rutubetsiz/uyanik/docs/case.png

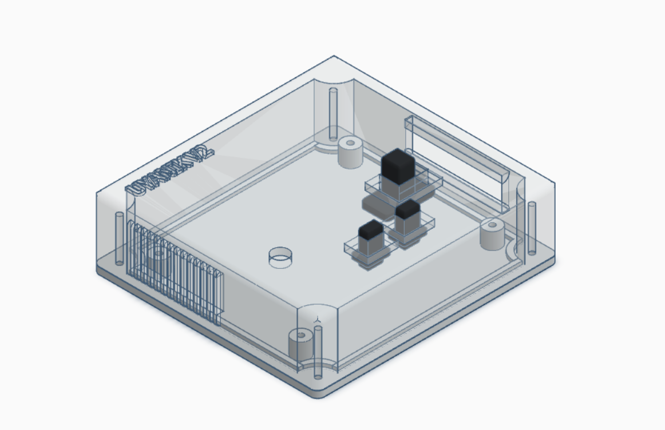
docs/case.png
