rutubetsiz/uyanik/docs/pcb.png

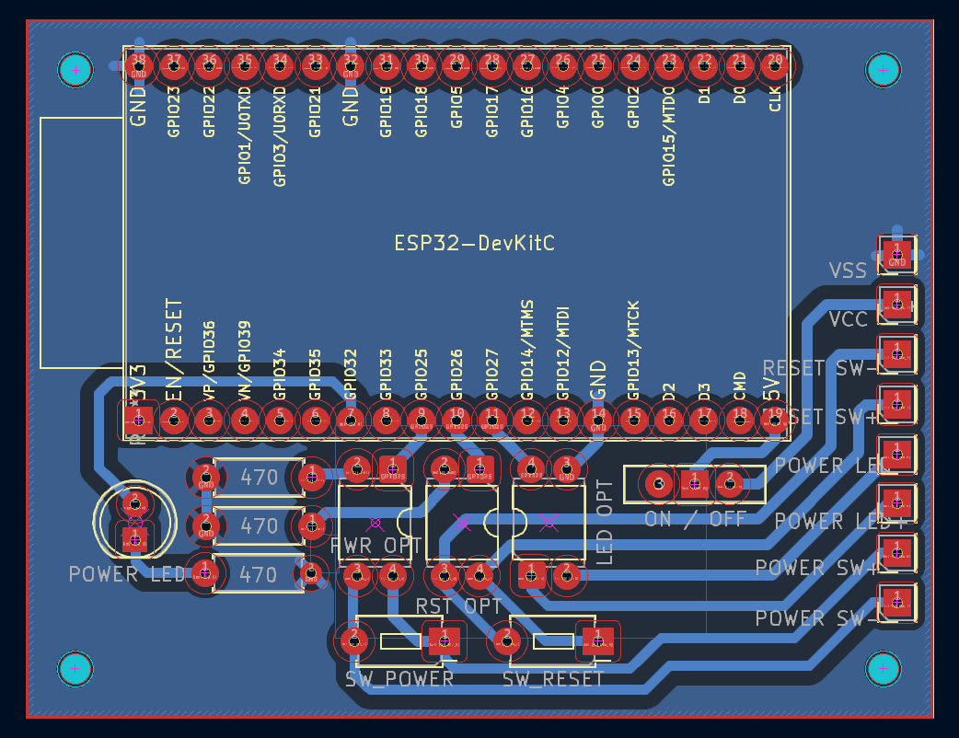
docs/pcb.png
