rutubetsiz/uyanik/case/UYANIK V2.stl

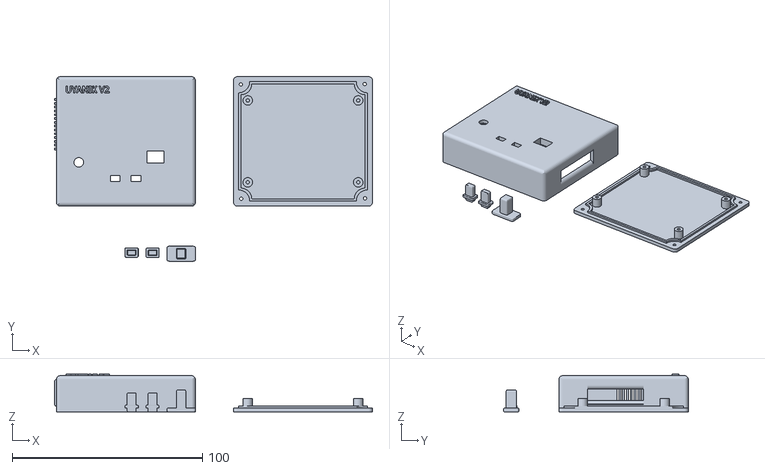
[picture p4: CAD file, 2026-10-16]
case/UYANIK V2.stl
167.0 x 97.0 x 19.8
