rutubetsiz/uyanik/hardware/UYANIK PCB.stl

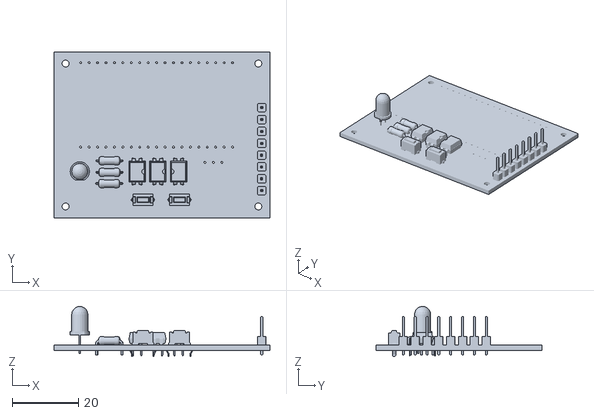
[picture p5: CAD file, 2026-10-16]
hardware/UYANIK PCB.stl
65.0 x 50.0 x 15.1
