rutubetsiz/uyanik/docs/Schematic.pdf

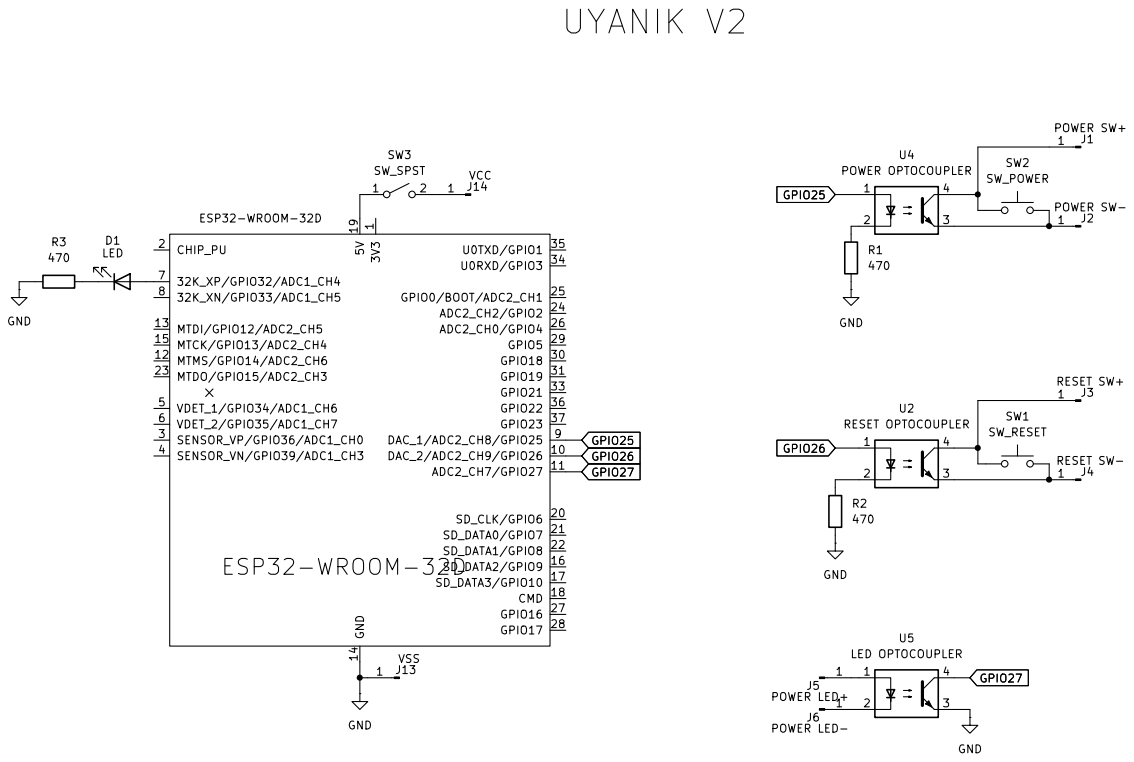
[picture p6: page 1]
