rutubetsiz/uyanik/hardware/UYANIK-B_Cu.pdf

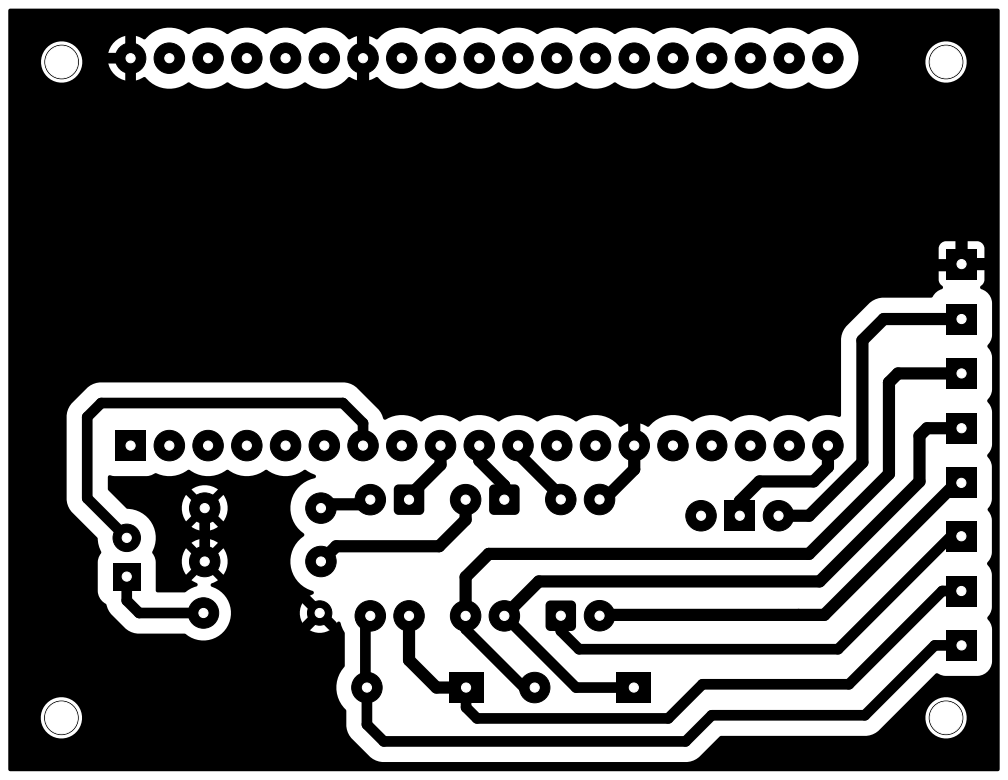
[picture p7: page 1]
