rutubetsiz/uyanik/hardware/UYANIK-B_Silkscreen.pdf

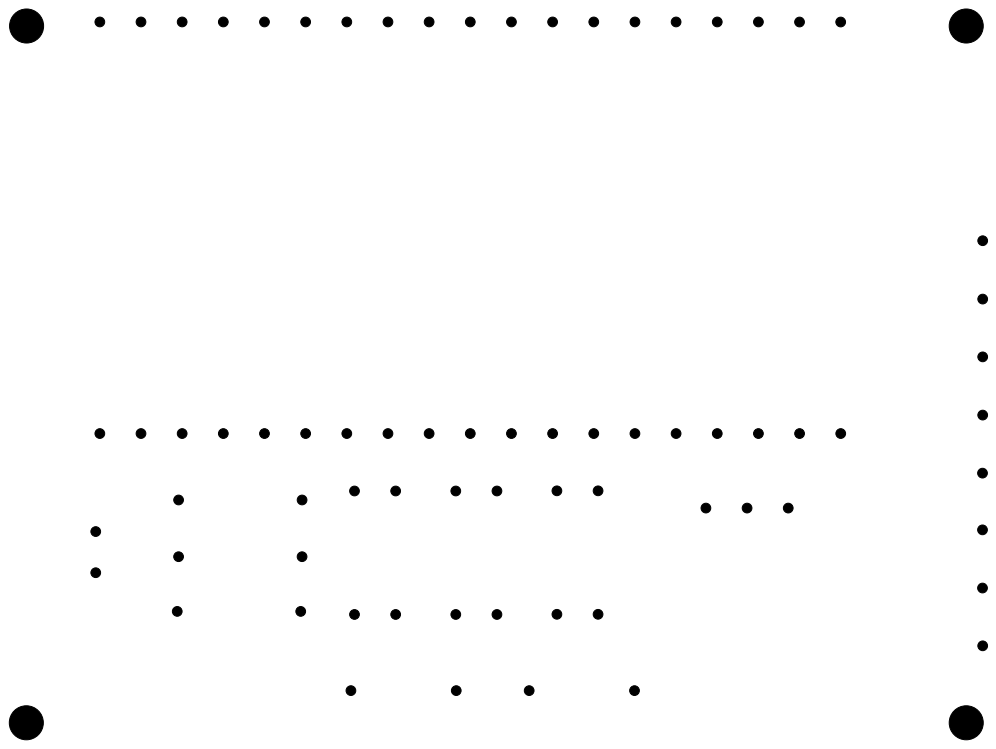
[picture p8: page 1]
