rutubetsiz/uyanik/hardware/UYANIK-F_Fab.pdf

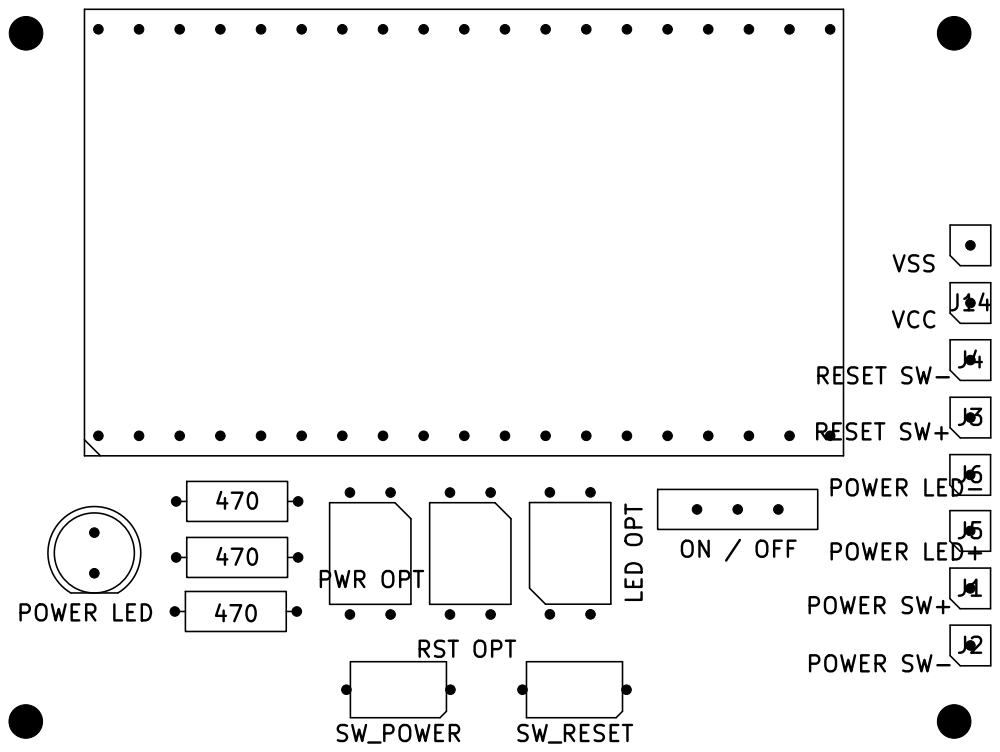
[picture p9: page 1]
