rutubetsiz/uyanik/hardware/UYANIK-F_Silkscreen.pdf

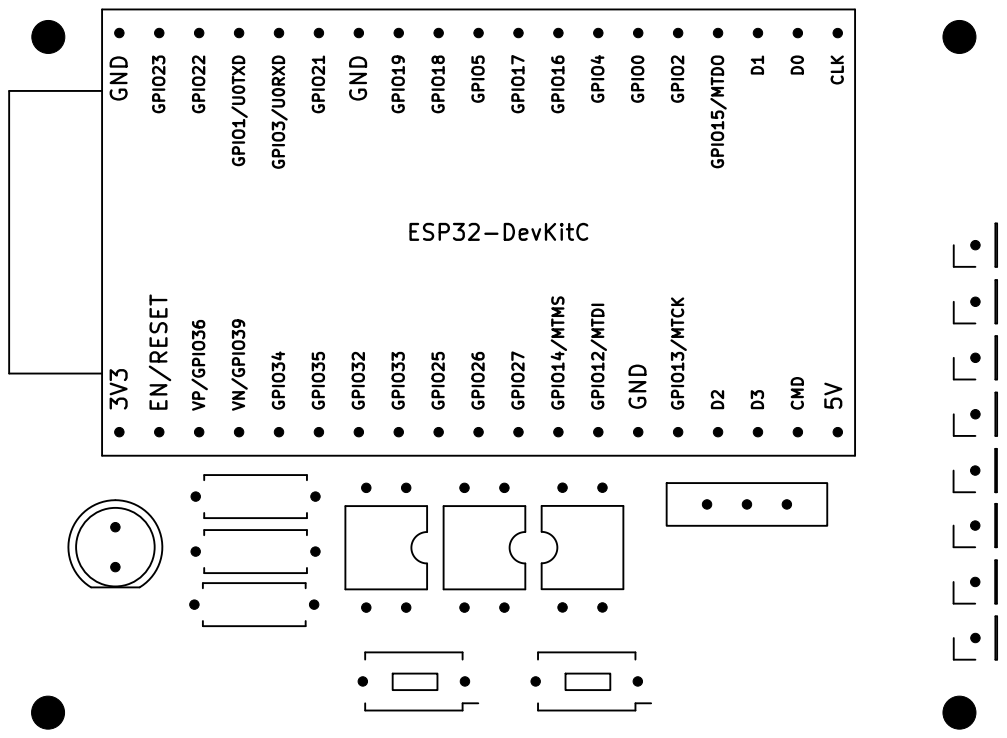
[picture p10: page 1]
