rutubetsiz/uyanik/hardware/UYANIK.kicad_pcb

## KiCad design hardware/UYANIK.kicad_pcb (2026-10-16)

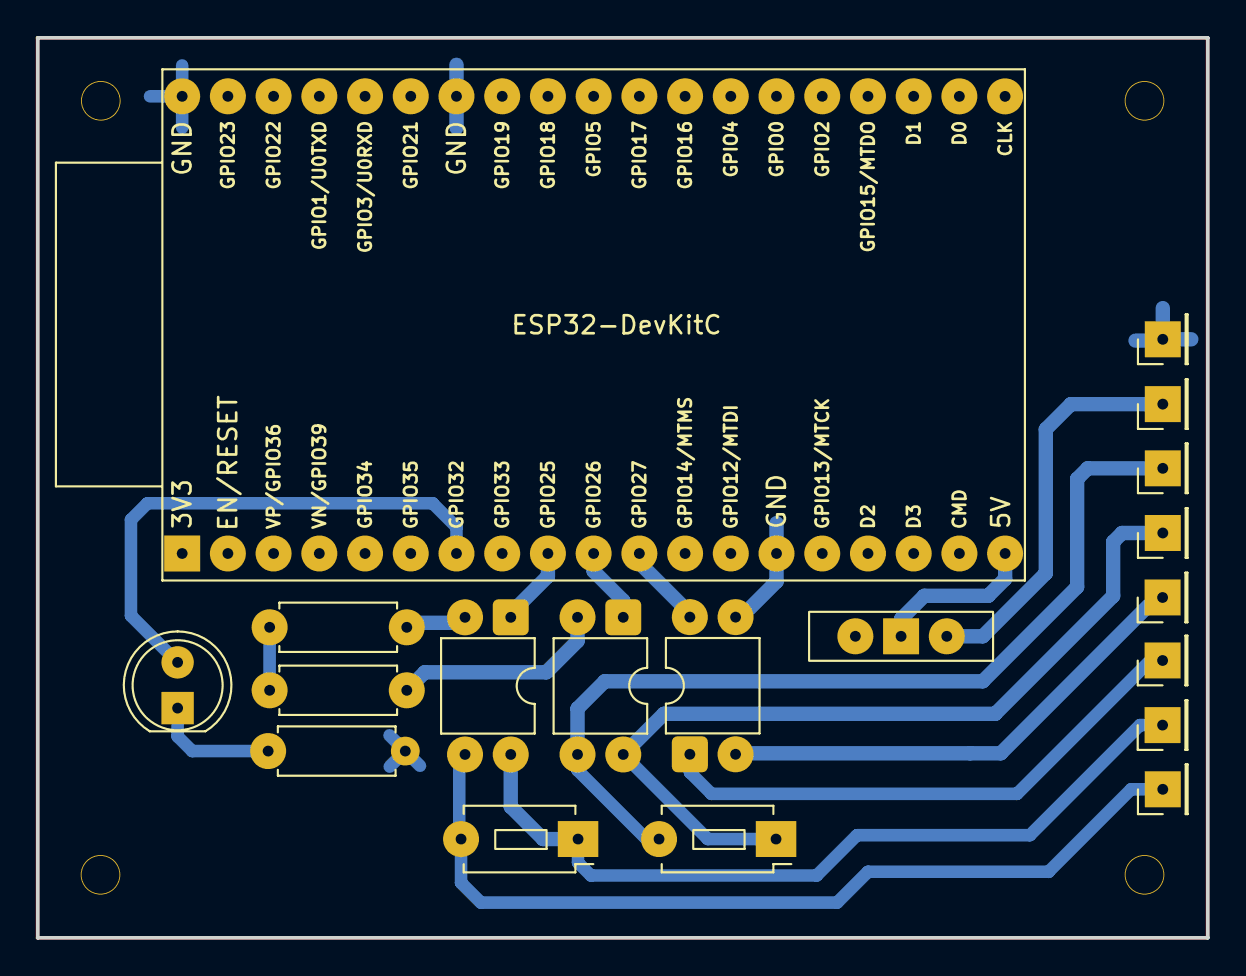
[picture p11: board UYANIK.kicad_pcb from above]

Board: 2 copper layers, 65.0 x 50.0 mm, 19 parts (0 on the bottom side), 16 nets.

Parts:
D1: POWER LED; LED_D5.0mm
J1: POWER SW+; PinHeader_1x01_P2.54mm_Vertical
J2: POWER SW-; PinHeader_1x01_P2.54mm_Vertical
J3: RESET SW+; PinHeader_1x01_P2.54mm_Vertical
J4: RESET SW-; PinHeader_1x01_P2.54mm_Vertical
J5: POWER LED+; PinHeader_1x01_P2.54mm_Vertical
J6: POWER LED-; PinHeader_1x01_P2.54mm_Vertical
J13: VSS; PinHeader_1x01_P2.54mm_Vertical
J14: VCC; PinHeader_1x01_P2.54mm_Vertical
R1, R2, R3: 470; R_Axial_DIN0207_L6.3mm_D2.5mm_P7.62mm_Horizontal
SW1: SW_RESET; SW_PUSH_1P1T_6x3.5mm_H4.3_APEM_MJTP1243
SW2: SW_POWER; SW_PUSH_1P1T_6x3.5mm_H4.3_APEM_MJTP1243
SW3: ON / OFF; SW_Slide-03_Wuerth-WS-SLTV_10x2.5x6.4_P2.54mm
U2: RST OPT; DIP-4_W7.62mm
U3: ESP32-DevKitC
U4: PWR OPT; DIP-4_W7.62mm
U5: LED OPT; DIP-4_W7.62mm

Connections:
GND: J13.1 (Pin_1_1), R1.2, R2.2, R3.2, U3.14 (GND), U3.32 (GND), U3.38 (GND), U5.3
GPIO25: U3.9 (DAC_1/ADC2_CH8/GPIO25), U4.1
GPIO26: U2.1, U3.10 (DAC_2/ADC2_CH9/GPIO26)
GPIO27: U3.11 (ADC2_CH7/GPIO27), U5.4
unnamed: D1.2 (A), U3.7 (32K_XP/GPIO32/ADC1_CH4)
unnamed: D1.1 (K), R3.1
unnamed: J1.1 (Pin_1_1), SW2.1, U4.4
unnamed: J2.1 (Pin_1_1), SW2.2, U4.3
unnamed: J3.1 (Pin_1_1), SW1.1, U2.4
unnamed: J4.1 (Pin_1_1), SW1.2, U2.3
unnamed: J5.1 (Pin_1_1), U5.1
unnamed: J6.1 (Pin_1_1), U5.2
unnamed: J14.1 (Pin_1_1), SW3.2 (B)
unnamed: R1.1, U4.2
unnamed: R2.1, U2.2
unnamed: SW3.1 (A), U3.19 (5V)
