rutubetsiz/uyanik/software/UYANIK/gts_root.h

// Copyright (C) 2026 rutubetsiz
// SPDX-License-Identifier: GPL-3.0-or-later

#pragma once

/*

Google Trust Services kök sertifikaları
22.06.2036 tarihine kadar geçerliler

Google Trust Services root certificates 
Valid until 22.06.2036

*/

const char GTS_ROOTS[] PROGMEM = R"CERT(-----BEGIN CERTIFICATE-----
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
bP6MvPJwNQzcmRk13NfIRmPVNnGuV/u3gm3c
-----END CERTIFICATE-----
-----BEGIN CERTIFICATE-----
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
6WLAYv7YTVWW4tAR+kg0Eeye7QUd5MjWHYbL
-----END CERTIFICATE-----
-----BEGIN CERTIFICATE-----
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
-----END CERTIFICATE-----
)CERT";
