rutubetsiz/uyanik/(commit log)

2026-10-16 UYANIK v2
    [UYANIK PCB.stl, UYANIK V2.stl, UYANIK.kicad_pcb, UYANIK.kicad_sch]
2026-10-16 Update README.tr.md with image and description
    Added an image and a brief description of the device.
